andrea-cpu96/RC-Car/EasyEDA (sch,pcb,BOM)/BOM_RC-Car_2024-02-27.csv

ID | Name | Designator | Footprint | Quantity | Manufacturer Part | Manufacturer | Supplier | Supplier Part | Price
1 | 10uF | C1,C6 | CAP-SMD_L3.2-W1.6-RD-C7171 | 2 | TAJA106K016RNJ | Kyocera AVX | LCSC | C7171 | 0.095
2 | 100nF | C2,C3,C4,C5,C15,C17 | C1206 | 6 | CL31B104KBCNNNC | SAMSUNG(三星) | LCSC | C24497 | 0.017
3 | 4.7uF | C7,C8,C9,C11 | C1206 | 4 | 1206B475K500NT | FH(风华) | LCSC | C29823 | 0.031
4 | 22uF | C10,C13 | CAP-SMD_L3.5-W2.8-R-RD | 2 | TPSB226K020R0400 | Kyocera AVX | LCSC | C308917 | 0.753
5 | 10uF | C12 | C0603 | 1 | CL10A106MA8NRNC | SAMSUNG(三星) | LCSC | C96446 | 0.018
6 | 470uF | C14,C16 | CAP-TH_BD8.0-P3.50-D0.6-FD | 2 | RXW471M1CBK-0815 | lelon(立隆) | LCSC | C134659 | 0.1
7 | 13pF | C18,C19 | C0402 | 2 | CC0402FRNPO9BN130 | YAGEO(国巨) | LCSC | C541433 | 0.003
8 | 1711725 | CN1 | CONN-TH_MKDS3-2-5.08 | 1 | 1711725 | Phoenix Contact(菲尼克斯) | LCSC | 1711725
9 | 53398-0771 | CN2 | CONN-SMD_7P-P1.25_53398-0771 | 1 | 533980771 | MOLEX | LCSC | C240849 | 0.227
10 | MKDS3/2-5.08 | CN3 | CONN-TH_MKDS3-2-5.08 | 1 | 1711725 | Phoenix Contact(菲尼克斯) | LCSC | C89120 | 0.681
11 | 1N4005-T | D1 | DO-41_BD2.4-L4.7-P8.70-D0.9-RD | 1 | 1N4005-T | DIODES(美台) | LCSC | C211377 | 0.032
12 | SB1240-3G | D2 | DO-201AD | 1 | SB1240-3G | MDD
13 | HDR-F-2.54_1x2 | H1 | HDR-F-2.54_1X2 | 1 |  |  | LCSC | C49661 | 0.036
14 | HDR-F-2.54_1x5 | H2 | HDR-F-2.54_1X5 | 1 |  |  | LCSC | C50950 | 0.062
15 | HDR-M-2.54_1x2 | J1 | HDR-M-2.54_1X2 | 1 |  |  | LCSC | C124375 | 0.023
16 | HDR-M-2.54_1x3 | J3,J4 | HDR-M-2.54_1X3 | 2 |  |  | LCSC | C180248 | 0.191
17 | 2.2mH | L1 | IND-TH_BD9.5-P5.20-D0.6 | 1 | PDPTAT0810-222K | PROD(谱罗德) | LCSC | C2924240 | 0.116
18 | 2mH | L2 | DENO230001 | 1 | DENO-23-0001 |  |  | DENO-23-0001
19 | BL-HGK35A-AV-TRB | LED1 | LED0805-RD_GREEN | 1 | BL-HGK35A-AV-TRB | BrtLed(佰鸿) | LCSC | C5123492 | 0.051
20 | TSM7P06CP_ROG | Q1,Q2 | TSM7P06CPROG | 2
21 | TSM950N10CW RPG | Q3,Q4 | SOT-223-3_L6.7-W3.7-P2.30-LS7.0-BR | 2 | TSM950N10CW RPG | Taiwan Semiconductor(台湾半导体) | LCSC | C3280039 | 0.772
22 | NSS40201LT1G | Q5,Q7 | SOT-23-3_L2.9-W1.6-P1.90-LS2.8-BR | 2 | NSS40201LT1G | onsemi(安森美) | LCSC | C145175 | 0.284
23 | AUIRF1010ZSTRL | Q6 | D2PAK_L10.0-W9.0-P2.54-LS15.0-BR | 1 | AUIRF1010ZSTRL | Infineon(英飞凌) | LCSC | C533212 | 2.172
24 | 4.7k | R1,R3 | R0805 | 2
25 | 10Ω | R2 | R1210 | 1 | AC1210JR-0710RL | YAGEO(国巨) | LCSC | C230387 | 0.027
26 | 10k | R4,R5,R6,R7,R20,R21 | R0805 | 6
27 | 5k | R8,R17,R18,R19 | R0805 | 4
28 | 22Ω | R9,R11,R12,R13,R14,R15 | R0805 | 6 | 0805W8F220JT5E | UNI-ROYAL(厚声) | LCSC | C17561 | 0.002
29 | 100kΩ | R10 | R0603 | 1 | 0603WAF1003T5E | UNI-ROYAL(厚声) | LCSC | C25803 | 0.001
30 | 10kΩ | R16 | R0603 | 1 | 0603WAF1002T5E | UNI-ROYAL(厚声) | LCSC | C25804 | 0.001
31 | 100k | R22,R25,R26 | R0805 | 3
32 | 80.6Ω | R23 | R0402 | 1 | CR0402FF80R6G | LIZ(丽智电子) | LCSC | C100536 | 0.001
33 | 1MΩ(DNP) | R24 | R0805 | 1 | AR05BTC1004 | Viking(光颉) | LCSC | C374666 | 0.038
34 | RA1113112R | S1 | SWITCH-2PIN | 1 | RA1113112R | E-Switch | Mouser | 612-RA1113112R
35 | AZ1117CH-5.0TRG1 | U1 | SOT-223_L6.5-W3.5-P2.30-LS7.0-BR | 1 | AZ1117CH-5.0TRG1 | DIODES(美台) | LCSC | C99342 | 0.058
36 | 100uF | U2,U7 | WCAP-PTG5_8X11.5(DXL) | 2 | 870025574005
37 | STM32F030CCT6 | U6 | LQFP-48_L7.0-W7.0-P0.50-LS9.0-BL | 1 | STM32F030CCT6 | ST(意法半导体) | LCSC | C81787 | 1.231
38 | AP7381-33SA-7 | U8 | SOT-23-3_L2.9-W1.3-P1.90-LS2.4-BR | 1 | AP7381-33SA-7 | DIODES(美台) | LCSC | C3752764 | 0.188
39 | 16MHz | X1 | CRYSTAL-SMD_4P-L3.2-W2.5-BL | 1 | TAXM16M4RDBCCT2T | TAE(雅晶鑫) | LCSC | C164044 | 0.066
40 | LMC662CN | U3 | PDIP-8_L9.3-W6.4-P2.54-LS7.6-BL | 1 | LMC662CN | TI(德州仪器) | LCSC | C4370054 | 0.889
