andrea-cpu96/RC-Car/EasyEDA (sch,pcb,BOM)/PCB_PCB_RC-Car_2024-02-27.pdf

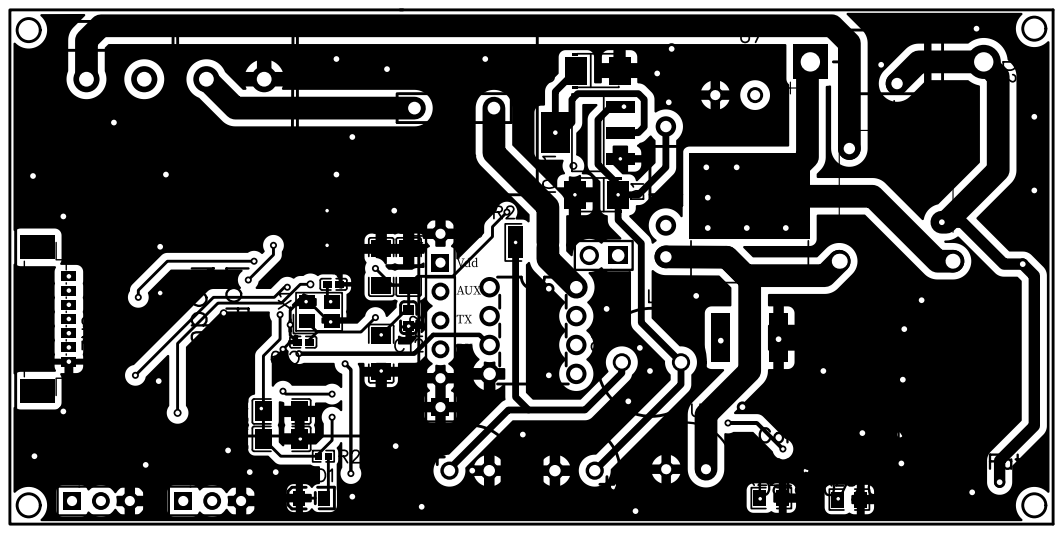
[picture p2: page 1]
