andrea-cpu96/RC-Car/EasyEDA (sch,pcb,BOM)/Schematic_RC-Car_2024-02-27.pdf

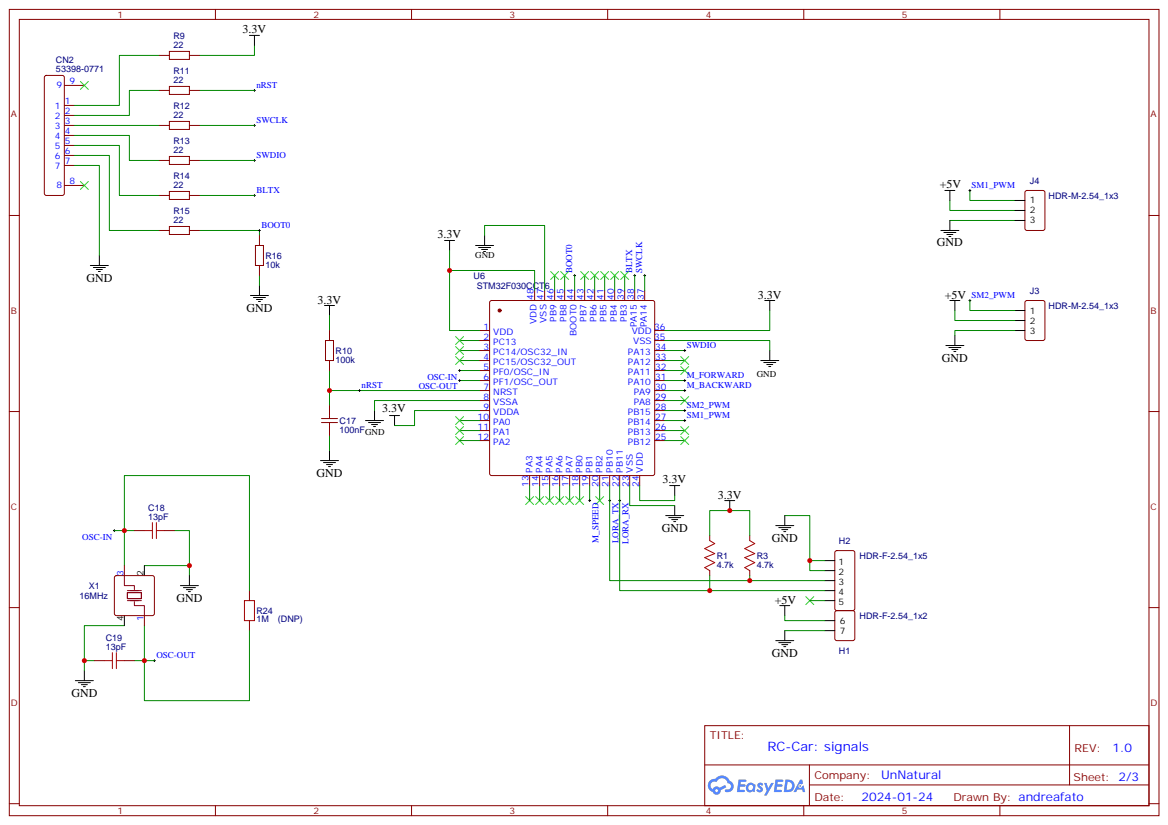
[picture p3: page 1]

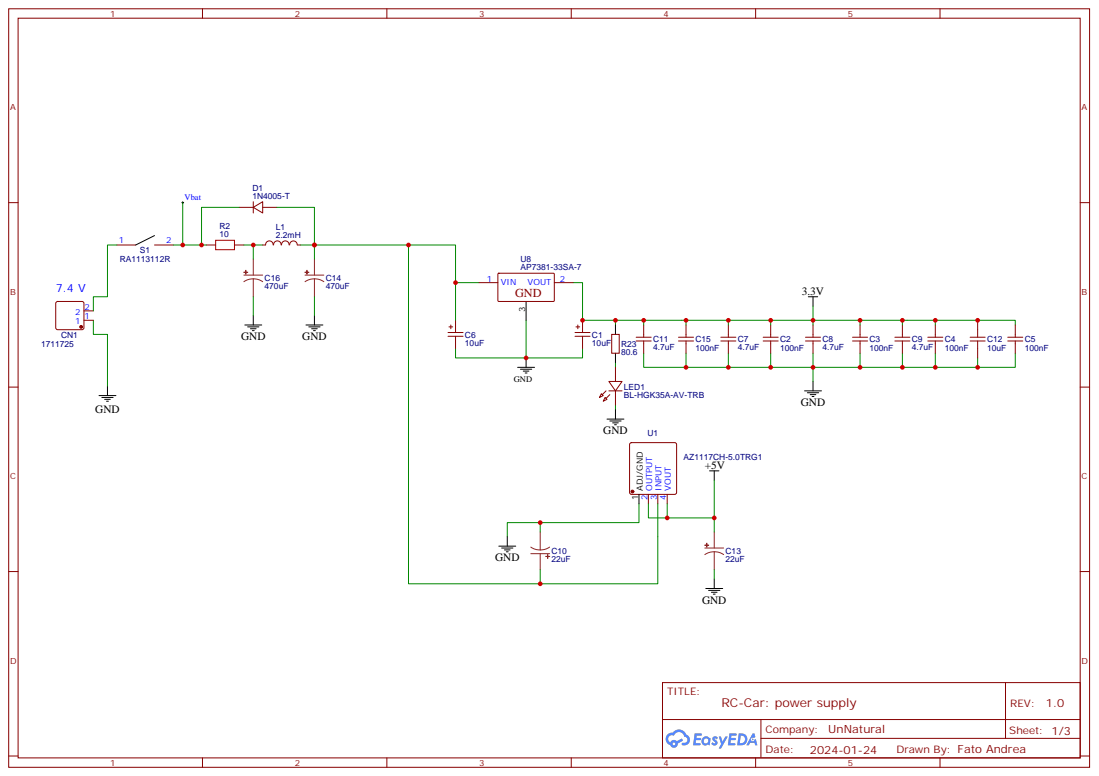
[picture p4: page 2]

Drawn By: Fato Andrea

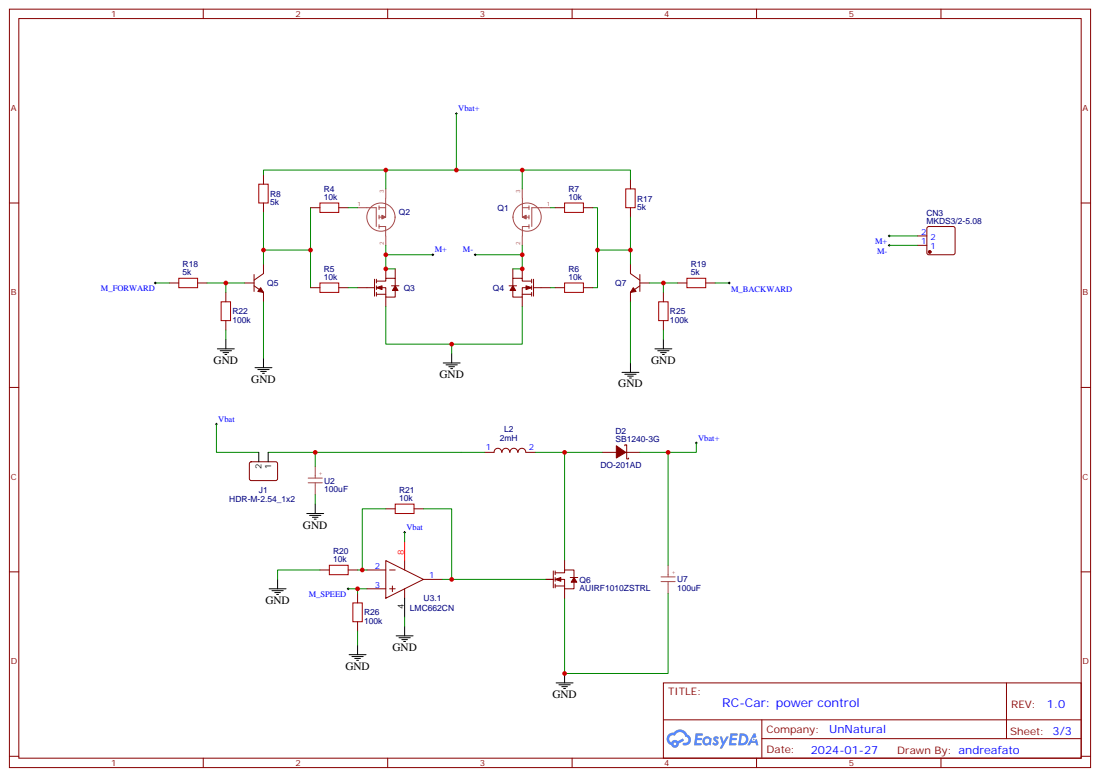
[picture p5: page 3]
