andrea-cpu96/RC-Car/LTspice (sim)/boost.asc

C1: cap; 666µ; V=75 Irms=4.14 Rser=0.035 Lser=0
D1: schottky; MBRB2545CT
L1: ind; 2m; Ipk=0.41 Rser=1.5456 Rpar=188400 Cpar=0 mfg="Coilcraft" pn="SPT50L-205"
M1: nmos; IRF1312S
R1: res; 500R
R2: res; 10k
R4: res; 10k
U2: MAX4436
V1: voltage; 8V
V2: voltage; PULSE(0 3.3V 0 1u 1u 25u 50u)
Named nets: 0, Vdd
.tran 20m
