andrea-cpu96/RC-Car/LTspice (sim)/LC-Filter.asc

C1: polcap; 470µ; V=2 Irms=2.16217 Rser=0.04 Lser=0 mfg="KEMET" pn="T520V477M002ATE040" type="Tantalum"
C2: polcap; 470µ; V=2 Irms=2.16217 Rser=0.04 Lser=0 mfg="KEMET" pn="T520V477M002ATE040" type="Tantalum"
L1: ind; 3.3m; Ipk=0.024 Rser=11 Rpar=631701 Cpar=0 mfg="Bourns, Inc." pn="SRR6603-332ML"
R1: res; 10R
R2: res; 100R
V1: voltage; ""; AC 1
Named nets: 0
.ac dec 100 1 100Meg
