andrea-cpu96/RC-Car/LTspice (sim)/mosfet-driver.asc

C2: cap; 1480p
Q1: npn; 2N2222
R1: res; 200R
R2: res; 100R
V1: voltage; PULSE(0 3.3 0 20n 20n 20u 50u)
V2: voltage; 8
Named nets: 0
.tran 8m
This circuit simulate the driving of the MOSFET
 
With this choise of components the slew rate of the signal at the 
output is of about 1us, which means we are losing 1us of duty-cycle.
 
R1 is chose in order to limit the current sinked from the microcontroller and 
also to speed up the bjt commutation.
It also saturates the bjt with V2/R2 < Ib*B.
 
R2 is a pull-up resistor. It soure the gate capacitance during ON-time.
It is chosen in order to mantain low current trhought the bjt, but low enought 
to charge C2 (gate capacitance) as fast as possible.
