andrea-cpu96/RC-Car/(list of files, drawings)

Other design files:
EasyEDA (sch,pcb,BOM)/Altium/PCB_RC-Car_2024-02-27.pcbdoc
EasyEDA (sch,pcb,BOM)/PCB_PCB_RC-Car_2024-02-27.json
EasyEDA (sch,pcb,BOM)/SCH_RC-Car_2024-02-27.json
