andrea-cpu96/RC-Car/RC-Car (stm32f030)/RC-Car/RC-Car.ioc

Mcu.UserName=STM32F030CCTx
PA10.GPIO_Label=M_FORWARD
PA10.Signal=GPIO_Output
PA13.Signal=SYS_SWDIO
PA14.Signal=SYS_SWCLK
PA9.GPIO_Label=M_BACKWARD
PA9.Signal=GPIO_Output
PB1.GPIO_Label=M_SPEED
PB1.Signal=S_TIM3_CH4
PB10.GPIO_Label=LORA_TX
PB10.Signal=USART3_TX
PB11.GPIO_Label=LORA_RX
PB11.Signal=USART3_RX
PB14.GPIO_Label=SM1_PWM
PB14.Signal=S_TIM15_CH1
PB15.GPIO_Label=SM2_PWM
PB15.Signal=S_TIM15_CH2
PF0-OSC_IN.Signal=RCC_OSC_IN
PF1-OSC_OUT.Signal=RCC_OSC_OUT
