andrea-cpu96/RC-Car/RC-Car (stm32f030)/RC-Car/Core/Inc/main.h

#define M_SPEED_Pin GPIO_PIN_1
#define M_SPEED_GPIO_Port GPIOB
#define LORA_TX_Pin GPIO_PIN_10
#define LORA_TX_GPIO_Port GPIOB
#define LORA_RX_Pin GPIO_PIN_11
#define LORA_RX_GPIO_Port GPIOB
#define SM1_PWM_Pin GPIO_PIN_14
#define SM1_PWM_GPIO_Port GPIOB
#define SM2_PWM_Pin GPIO_PIN_15
#define SM2_PWM_GPIO_Port GPIOB
#define M_BACKWARD_Pin GPIO_PIN_9
#define M_BACKWARD_GPIO_Port GPIOA
#define M_FORWARD_Pin GPIO_PIN_10
#define M_FORWARD_GPIO_Port GPIOA
