andrea-cpu96/RC-Car/(notices)

Notices in the files:
RC-Car (stm32f030)/RC-Car/Core/Inc/main.h:
Copyright (c) 2024 STMicroelectronics.
All rights reserved.
This software is licensed under terms that can be found in the LICENSE file
